Heking114514/STM32-SIMPLE-WATCH/scripts/font_file/readme.txt

各字号在 Flash 中的起始地址 (十六进制):
各字号在 Flash 中的起始绝对地址 (Hex):
  12x12: 0x00000000
  16x16: 0x0002FEB0
  24x24: 0x0006FCF0
  32x32: 0x000FF900
