Heking114514/STM32-SIMPLE-WATCH/Core/Inc/main.h

#define ADC_Pin GPIO_PIN_0
#define ADC_GPIO_Port GPIOA
#define KEY3_Pin GPIO_PIN_1
#define KEY3_GPIO_Port GPIOA
#define YX_RX_Pin GPIO_PIN_2
#define YX_RX_GPIO_Port GPIOA
#define YX_TX_Pin GPIO_PIN_3
#define YX_TX_GPIO_Port GPIOA
#define W25_CS_Pin GPIO_PIN_4
#define W25_CS_GPIO_Port GPIOA
#define W25_CLK_Pin GPIO_PIN_5
#define W25_CLK_GPIO_Port GPIOA
#define W25_DO_Pin GPIO_PIN_6
#define W25_DO_GPIO_Port GPIOA
#define W25_DI_Pin GPIO_PIN_7
#define W25_DI_GPIO_Port GPIOA
#define KEY2_Pin GPIO_PIN_0
#define KEY2_GPIO_Port GPIOB
#define KEY1_Pin GPIO_PIN_1
#define KEY1_GPIO_Port GPIOB
#define BAT_ADC_EN_Pin GPIO_PIN_12
#define BAT_ADC_EN_GPIO_Port GPIOB
#define MP3VCC_Pin GPIO_PIN_11
#define MP3VCC_GPIO_Port GPIOA
#define APK_OFF_Pin GPIO_PIN_12
#define APK_OFF_GPIO_Port GPIOA
#define LED_Pin GPIO_PIN_6
#define LED_GPIO_Port GPIOB
#define KEY4_Pin GPIO_PIN_7
#define KEY4_GPIO_Port GPIOB
