Heking114514/STM32-SIMPLE-WATCH/Modules/mpu6050.c

#include <math.h>
#include "mpu6050.h"
#include "i2c.h" // 引用 hi2c1

// 弧度转角度 1rad = 57.2958°
#define RAD_TO_DEG 57.295779513082320876798154814105

#define MPU6050_ADDR 0xD0
#define WHO_AM_I_REG 0x75
#define PWR_MGMT_1_REG 0x6B
#define SMPLRT_DIV_REG 0x19
#define ACCEL_CONFIG_REG 0x1C
#define ACCEL_XOUT_H_REG 0x3B
#define TEMP_OUT_H_REG 0x41
#define GYRO_CONFIG_REG 0x1B
#define GYRO_XOUT_H_REG 0x43

const uint16_t i2c_timeout = 100;
const double Accel_Z_corrector = 14418.0;

// --- 内部变量 ---
static uint32_t timer = 0;
static float yaw_angle = 0;

// 全局唯一的 MPU 数据实例 (供 UI 使用)
static MPU6050_t g_mpu_data;

Kalman_t KalmanX = { .Q_angle = 0.001f, .Q_bias = 0.003f, .R_measure = 0.03f };
Kalman_t KalmanY = { .Q_angle = 0.001f, .Q_bias = 0.003f, .R_measure = 0.03f };

// 声明外部 I2C 句柄 (CubeMX生成)
extern I2C_HandleTypeDef hi2c2; 

// ========================================================
//   核心驱动函数
// ========================================================

uint8_t MPU6050_Init(I2C_HandleTypeDef *I2Cx)
{
    uint8_t check;
    uint8_t Data;

    // 1. 检查设备 ID
    HAL_I2C_Mem_Read(I2Cx, MPU6050_ADDR, WHO_AM_I_REG, 1, &check, 1, i2c_timeout);

    if (check == 104) // 0x68
    {
        // 2. 唤醒传感器
        Data = 0;
        HAL_I2C_Mem_Write(I2Cx, MPU6050_ADDR, PWR_MGMT_1_REG, 1, &Data, 1, i2c_timeout);

        // 3. 设置采样率分频
        Data = 0x07;
        HAL_I2C_Mem_Write(I2Cx, MPU6050_ADDR, SMPLRT_DIV_REG, 1, &Data, 1, i2c_timeout);

        // 4. 加速度计配置
        Data = 0x00; // ±2g
        HAL_I2C_Mem_Write(I2Cx, MPU6050_ADDR, ACCEL_CONFIG_REG, 1, &Data, 1, i2c_timeout);

        // 5. 陀螺仪配置
        Data = 0x00; // ±250 °/s
        HAL_I2C_Mem_Write(I2Cx, MPU6050_ADDR, GYRO_CONFIG_REG, 1, &Data, 1, i2c_timeout);
        
        timer = HAL_GetTick(); // 初始化计时器
        return 0; // 成功
    }
    return 1; // 失败
}

double Kalman_getAngle(Kalman_t *Kalman, double newAngle, double newRate, double dt)
{
    double rate = newRate - Kalman->bias;
    Kalman->angle += dt * rate;

    Kalman->P[0][0] += dt * (dt * Kalman->P[1][1] - Kalman->P[0][1] - Kalman->P[1][0] + Kalman->Q_angle);
    Kalman->P[0][1] -= dt * Kalman->P[1][1];
    Kalman->P[1][0] -= dt * Kalman->P[1][1];
    Kalman->P[1][1] += Kalman->Q_bias * dt;

    double S = Kalman->P[0][0] + Kalman->R_measure;
    double K[2];
    K[0] = Kalman->P[0][0] / S;
    K[1] = Kalman->P[1][0] / S;

    double gap = newAngle - Kalman->angle;
    Kalman->angle += K[0] * gap;
    Kalman->bias += K[1] * gap;

    double P00_temp = Kalman->P[0][0];
    double P01_temp = Kalman->P[0][1];

    Kalman->P[0][0] -= K[0] * P00_temp;
    Kalman->P[0][1] -= K[0] * P01_temp;
    Kalman->P[1][0] -= K[1] * P00_temp;
    Kalman->P[1][1] -= K[1] * P01_temp;

    return Kalman->angle;
}

void MPU6050_Read_All(I2C_HandleTypeDef *I2Cx, MPU6050_t *DataStruct)
{
    uint8_t Rec_Data[14];
    int16_t temp;

    // 批量读取 14 个寄存器
    HAL_I2C_Mem_Read(I2Cx, MPU6050_ADDR, ACCEL_XOUT_H_REG, 1, Rec_Data, 14, i2c_timeout);

    DataStruct->Accel_X_RAW = (int16_t)(Rec_Data[0] << 8 | Rec_Data[1]);
    DataStruct->Accel_Y_RAW = (int16_t)(Rec_Data[2] << 8 | Rec_Data[3]);
    DataStruct->Accel_Z_RAW = (int16_t)(Rec_Data[4] << 8 | Rec_Data[5]);
    temp = (int16_t)(Rec_Data[6] << 8 | Rec_Data[7]);
    DataStruct->Gyro_X_RAW = (int16_t)(Rec_Data[8] << 8 | Rec_Data[9]);
    DataStruct->Gyro_Y_RAW = (int16_t)(Rec_Data[10] << 8 | Rec_Data[11]);
    DataStruct->Gyro_Z_RAW = (int16_t)(Rec_Data[12] << 8 | Rec_Data[13]);

    DataStruct->Ax = DataStruct->Accel_X_RAW / 16384.0;
    DataStruct->Ay = DataStruct->Accel_Y_RAW / 16384.0;
    DataStruct->Az = DataStruct->Accel_Z_RAW / Accel_Z_corrector;
    DataStruct->Temperature = (float)((int16_t)temp / (float)340.0 + (float)36.53);
    
    DataStruct->Gx = DataStruct->Gyro_X_RAW / 131.0;
    DataStruct->Gy = DataStruct->Gyro_Y_RAW / 131.0;
    DataStruct->Gz = (DataStruct->Gyro_Z_RAW / 131.0); // 简单的零飘修正需根据实际校准

    // 简单死区处理
    if(DataStruct->Gz > -1 && DataStruct->Gz < 1) DataStruct->Gz = 0;

    // --- 卡尔曼滤波解算 ---
    double dt = (double)(HAL_GetTick() - timer) / 1000.0;
    timer = HAL_GetTick();
    
    // 防止 dt 为 0 或过大（初始化时）
    if(dt <= 0) dt = 0.001; 

    double roll;
    double roll_sqrt = sqrt(DataStruct->Accel_X_RAW * DataStruct->Accel_X_RAW + DataStruct->Accel_Z_RAW * DataStruct->Accel_Z_RAW);
    
    if (roll_sqrt != 0.0)
        roll = atan(DataStruct->Accel_Y_RAW / roll_sqrt) * RAD_TO_DEG;
    else
        roll = 0.0;

    double pitch = atan2(-DataStruct->Accel_X_RAW, DataStruct->Accel_Z_RAW) * RAD_TO_DEG;

    if ((pitch < -90 && DataStruct->KalmanAngleY > 90) || (pitch > 90 && DataStruct->KalmanAngleY < -90))
    {
        KalmanY.angle = pitch;
        DataStruct->KalmanAngleY = pitch;
    }
    else
    {
        DataStruct->KalmanAngleY = Kalman_getAngle(&KalmanY, pitch, DataStruct->Gy, dt);
    }

    if (fabs(DataStruct->KalmanAngleY) > 90)
        DataStruct->Gx = -DataStruct->Gx;
        
    DataStruct->KalmanAngleX = Kalman_getAngle(&KalmanX, roll, DataStruct->Gx, dt);

    // Yaw 角积分
    yaw_angle += DataStruct->Gz * dt;
    DataStruct->KalmanAngleZ = yaw_angle;
}

// ========================================================
//   新增：应用层接口
// ========================================================

// 1. 获取全局数据指针 (供 menu_data.c 使用)
const MPU6050_t* MPU6050_GetDataPtr(void)
{
    return &g_mpu_data;
}

// 2. 定时更新任务 (供 main.c 调用)
// 建议每 10-20ms 调用一次
void MPU6050_Update_Task(void)
{
    // 使用全局 i2c 句柄更新全局数据结构
    MPU6050_Read_All(&hi2c2, &g_mpu_data);
}
