Heking114514/STM32-SIMPLE-WATCH/Modules/mpu6050.h

#ifndef INC_GY521_H_
#define INC_GY521_H_

#include <stdint.h>
#include "i2c.h"

// MPU6050 结构体
typedef struct
{
    int16_t Accel_X_RAW;
    int16_t Accel_Y_RAW;
    int16_t Accel_Z_RAW;
    double Ax;
    double Ay;
    double Az;

    int16_t Gyro_X_RAW;
    int16_t Gyro_Y_RAW;
    int16_t Gyro_Z_RAW;
    double Gx;
    double Gy;
    double Gz;

    float Temperature;

    double KalmanAngleX;
    double KalmanAngleY;
    double KalmanAngleZ; // 用于 Yaw 估算
} MPU6050_t;

// 卡尔曼结构体
typedef struct
{
    double Q_angle;
    double Q_bias;
    double R_measure;
    double angle;
    double bias;
    double P[2][2];
} Kalman_t;

// --- 基础驱动 ---
uint8_t MPU6050_Init(I2C_HandleTypeDef *I2Cx);
void MPU6050_Read_All(I2C_HandleTypeDef *I2Cx, MPU6050_t *DataStruct);

// --- 新增：上层应用接口 ---
void MPU6050_Update_Task(void); // 在 main while(1) 中调用
const MPU6050_t* MPU6050_GetDataPtr(void); // 供 UI 获取数据

#endif
